microlab-unibg/GAPS_winter_monitor/Winter_PCB/Winter_v2.brd

## EAGLE design Winter_PCB/Winter_v2.brd (2022-06-06)

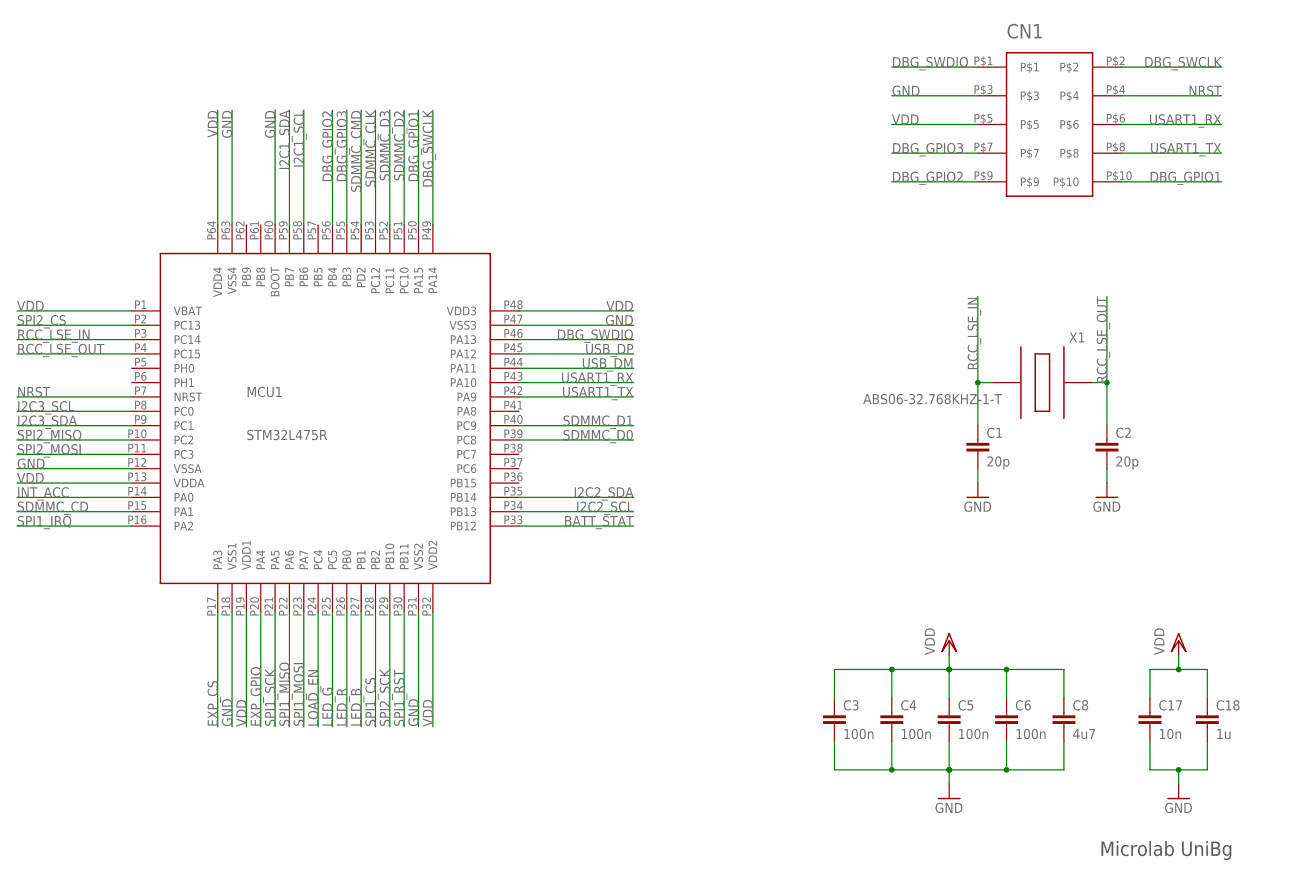
[picture p1: schematic Winter_v2.sch, sheet 1]

Parts:
C1, C2: 20p; C0402
C3, C4, C5, C6: 100n; C0402
C8: 4u7; C0402
C17: 10n; C0402
C18: 1u; C0402
CN1: FTSH-105TO; FTSH-105-XX
MCU1: STM32L475R; LQFP64
X1: ABS06-32.768KHZ-1-T; ABS06

Connections:
BATT_STAT: MCU1.P33 (PB12); also elsewhere on the board
DBG_GPIO1: CN1.P$10, MCU1.P50 (PA15)
DBG_GPIO2: CN1.P$9, MCU1.P56 (PB4)
DBG_GPIO3: CN1.P$7, MCU1.P55 (PB3)
DBG_SWCLK: CN1.P$2, MCU1.P49 (PA14)
DBG_SWDIO: CN1.P$1, MCU1.P46 (PA13)
EXP_CS: MCU1.P17 (PA3); also elsewhere on the board
EXP_GPIO: MCU1.P20 (PA4); also elsewhere on the board
GND: C1.P$2 (2), C2.P$2 (2), C3.P$2 (2), C4.P$2 (2), C5.P$2 (2), C6.P$2 (2), C8.P$2 (2), C17.P$2 (2), C18.P$2 (2), CN1.P$3, MCU1.P12 (VSSA), MCU1.P18 (VSS1), MCU1.P31 (VSS2), MCU1.P47 (VSS3), MCU1.P60 (BOOT), MCU1.P63 (VSS4); also elsewhere on the board
I2C1_SCL: MCU1.P58 (PB6); also elsewhere on the board
I2C1_SDA: MCU1.P59 (PB7); also elsewhere on the board
I2C2_SCL: MCU1.P34 (PB13); also elsewhere on the board
I2C2_SDA: MCU1.P35 (PB14); also elsewhere on the board
I2C3_SCL: MCU1.P8 (PC0); also elsewhere on the board
I2C3_SDA: MCU1.P9 (PC1); also elsewhere on the board
INT_ACC: MCU1.P14 (PA0); also elsewhere on the board
LED_B: MCU1.P27 (PB1); also elsewhere on the board
LED_G: MCU1.P25 (PC5); also elsewhere on the board
LED_R: MCU1.P26 (PB0); also elsewhere on the board
LOAD_EN: MCU1.P24 (PC4); also elsewhere on the board
NRST: CN1.P$4, MCU1.P7 (NRST)
RCC_LSE_IN: C1.P$1 (1), MCU1.P3 (PC14), X1.P1
RCC_LSE_OUT: C2.P$1 (1), MCU1.P4 (PC15), X1.P2
SDMMC_CD: MCU1.P15 (PA1); also elsewhere on the board
SDMMC_CLK: MCU1.P53 (PC12); also elsewhere on the board
SDMMC_CMD: MCU1.P54 (PD2); also elsewhere on the board
SDMMC_D0: MCU1.P39 (PC8); also elsewhere on the board
SDMMC_D1: MCU1.P40 (PC9); also elsewhere on the board
SDMMC_D2: MCU1.P51 (PC10); also elsewhere on the board
SDMMC_D3: MCU1.P52 (PC11); also elsewhere on the board
SPI1_CS: MCU1.P28 (PB2); also elsewhere on the board
SPI1_IRQ: MCU1.P16 (PA2); also elsewhere on the board
SPI1_MISO: MCU1.P22 (PA6); also elsewhere on the board
SPI1_MOSI: MCU1.P23 (PA7); also elsewhere on the board
SPI1_RST: MCU1.P30 (PB11); also elsewhere on the board
SPI1_SCK: MCU1.P21 (PA5); also elsewhere on the board
SPI2_CS: MCU1.P2 (PC13); also elsewhere on the board
SPI2_MISO: MCU1.P10 (PC2); also elsewhere on the board
SPI2_MOSI: MCU1.P11 (PC3); also elsewhere on the board
SPI2_SCK: MCU1.P29 (PB10); also elsewhere on the board
USART1_RX: CN1.P$6, MCU1.P43 (PA10)
USART1_TX: CN1.P$8, MCU1.P42 (PA9)
USB_DM: MCU1.P44 (PA11); also elsewhere on the board
USB_DP: MCU1.P45 (PA12); also elsewhere on the board
VDD: C3.P$1 (1), C4.P$1 (1), C5.P$1 (1), C6.P$1 (1), C8.P$1 (1), C17.P$1 (1), C18.P$1 (1), CN1.P$5, MCU1.P1 (VBAT), MCU1.P13 (VDDA), MCU1.P19 (VDD1), MCU1.P32 (VDD2), MCU1.P48 (VDD3), MCU1.P64 (VDD4); also elsewhere on the board

Notes on the sheet:
Microlab UniBg

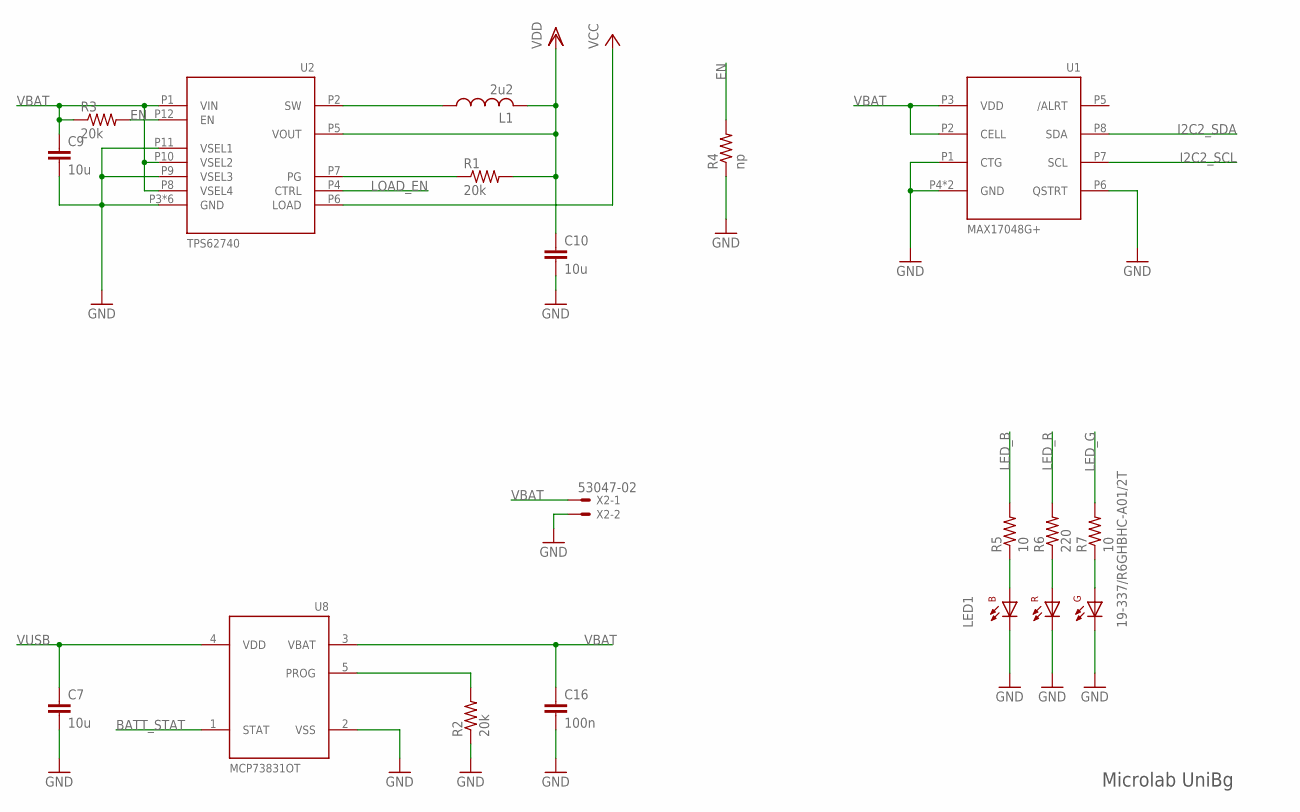
[picture p2: schematic Winter_v2.sch, sheet 2]

Parts:
C7, C9, C10: 10u; C0603
C16: 100n; C0402
L1: 2u2; C01005
LED1: 19-337/R6GHBHC-A01/2T
R1, R2, R3: 20k; 0402
R4: np; 0402
R5, R7: 10; 0402
R6: 220; 0402
U1: MAX17048G+; TDFN8-2X2
U2: TPS62740; R-PWSON-N12
U8: MCP73831OT; SOT23-5L
X2: 53047-02

Connections:
BATT_STAT: U8.1 (STAT); also elsewhere on the board
EN: R3.P$2 (2), R4.P$2 (2), U2.P12 (EN)
GND: C7.P$2 (2), C9.P$2 (2), C10.P$2 (2), C16.P$2 (2), LED1.P$1 (CB), LED1.P$2 (CR), LED1.P$3 (CG), R2.P$1 (1), R4.P$1 (1), U1.P1 (CTG), U1.P4 (GND), U1.P6 (QSTRT), U1.P9 (GND), U2.P3 (GND), U2.P9 (VSEL3), U2.P11 (VSEL1), U2.PG1 (GND), U2.PG2 (GND), U2.PG3 (GND), U2.PG4 (GND), U2.PG5 (GND), U8.2 (VSS), X2.2; also elsewhere on the board
I2C2_SCL: U1.P7 (SCL); also elsewhere on the board
I2C2_SDA: U1.P8 (SDA); also elsewhere on the board
LED_B: R5.P$2 (2); also elsewhere on the board
LED_G: R7.P$2 (2); also elsewhere on the board
LED_R: R6.P$2 (2); also elsewhere on the board
LOAD_EN: U2.P4 (CTRL); also elsewhere on the board
unnamed: L1.P$1 (1), U2.P2 (SW)
unnamed: R1.P$1 (1), U2.P7 (PG)
unnamed: LED1.P$4 (AB), R5.P$1 (1)
unnamed: LED1.P$5 (AR), R6.P$1 (1)
unnamed: LED1.P$6 (AG), R7.P$1 (1)
unnamed: R2.P$2 (2), U8.5 (PROG)
VBAT: C9.P$1 (1), C16.P$1 (1), R3.P$1 (1), U1.P2 (CELL), U1.P3 (VDD), U2.P1 (VIN), U2.P8 (VSEL4), U2.P10 (VSEL2), U8.3 (VBAT), X2.1; also elsewhere on the board
VCC: U2.P6 (LOAD); also elsewhere on the board
VDD: C10.P$1 (1), L1.P$2 (2), R1.P$2 (2), U2.P5 (VOUT); also elsewhere on the board
VUSB: C7.P$1 (1), U8.4 (VDD); also elsewhere on the board

Notes on the sheet:
Microlab UniBg

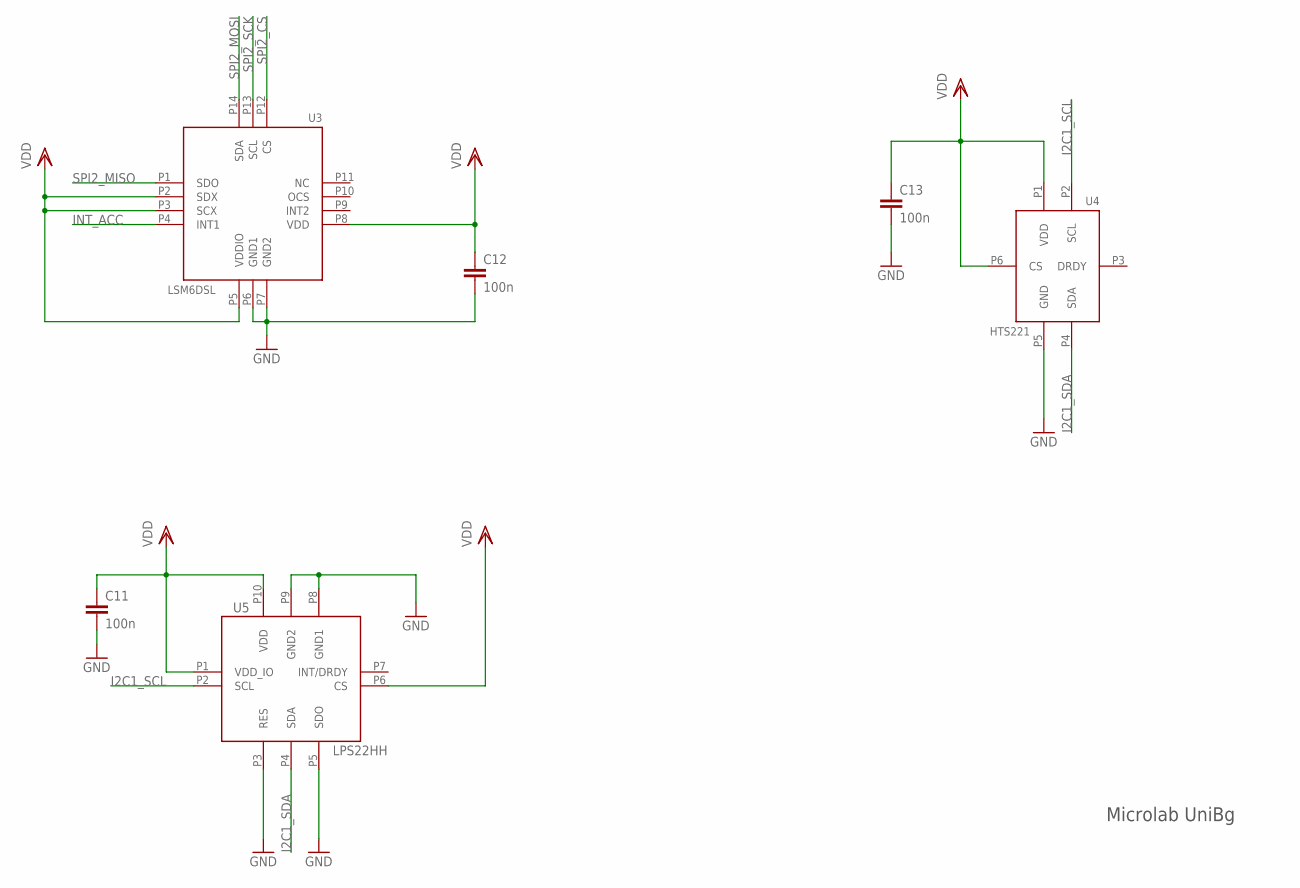
[picture p3: schematic Winter_v2.sch, sheet 3]

Parts:
C11, C12, C13: 100n; C0402
U3: LSM6DSL; LGA-14L
U4: HTS221; HCLGA-6L
U5: LPS22HH; HLGA-10L

Connections:
GND: C11.P$2 (2), C12.P$2 (2), C13.P$2 (2), U3.P6 (GND1), U3.P7 (GND2), U4.P5 (GND), U5.P3 (RES), U5.P5 (SDO), U5.P8 (GND1), U5.P9 (GND2); also elsewhere on the board
I2C1_SCL: U4.P2 (SCL), U5.P2 (SCL); also elsewhere on the board
I2C1_SDA: U4.P4 (SDA), U5.P4 (SDA); also elsewhere on the board
INT_ACC: U3.P4 (INT1); also elsewhere on the board
SPI2_CS: U3.P12 (CS); also elsewhere on the board
SPI2_MISO: U3.P1 (SDO); also elsewhere on the board
SPI2_MOSI: U3.P14 (SDA); also elsewhere on the board
SPI2_SCK: U3.P13 (SCL); also elsewhere on the board
VDD: C11.P$1 (1), C12.P$1 (1), C13.P$1 (1), U3.P2 (SDX), U3.P3 (SCX), U3.P5 (VDDIO), U3.P8 (VDD), U4.P1 (VDD), U4.P6 (CS), U5.P1 (VDD_IO), U5.P6 (CS), U5.P10 (VDD); also elsewhere on the board

Notes on the sheet:
Microlab UniBg

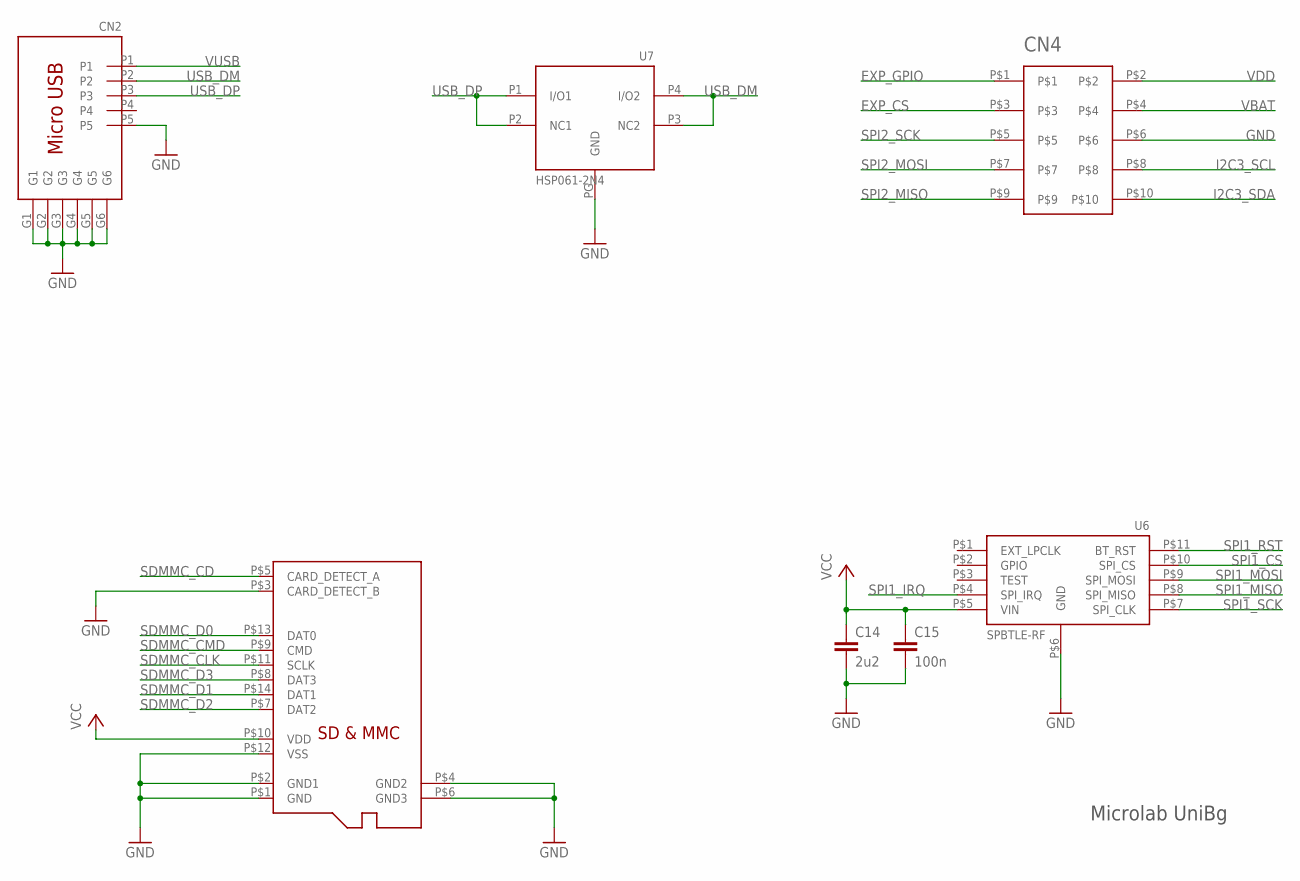
[picture p4: schematic Winter_v2.sch, sheet 4]

Parts:
C14: 2u2; C0402
C15: 100n; C0402
CN2: USB3075
CN3: MICRO_SD-5025700893; 5025700893
CN4: FTSH-105TO; FTSH-105-XX
U6: SPBTLE-RF
U7: HSP061-2N4; μQFN-4L

Connections:
EXP_CS: CN4.P$3; also elsewhere on the board
EXP_GPIO: CN4.P$1; also elsewhere on the board
GND: C14.P$2 (2), C15.P$2 (2), CN2.G1, CN2.G2, CN2.G3, CN2.G4, CN2.G5, CN2.G6, CN2.P5, CN3.P$1 (GND), CN3.P$2 (GND1), CN3.P$3 (CARD_DETECT_B), CN3.P$4 (GND2), CN3.P$6 (GND3), CN3.P$12 (VSS), CN4.P$6, U6.P$6 (GND), U7.PG (GND); also elsewhere on the board
I2C3_SCL: CN4.P$8; also elsewhere on the board
I2C3_SDA: CN4.P$10; also elsewhere on the board
SDMMC_CD: CN3.P$5 (CARD_DETECT_A); also elsewhere on the board
SDMMC_CLK: CN3.P$11 (SCLK); also elsewhere on the board
SDMMC_CMD: CN3.P$9 (CMD); also elsewhere on the board
SDMMC_D0: CN3.P$13 (DAT0); also elsewhere on the board
SDMMC_D1: CN3.P$14 (DAT1); also elsewhere on the board
SDMMC_D2: CN3.P$7 (DAT2); also elsewhere on the board
SDMMC_D3: CN3.P$8 (DAT3); also elsewhere on the board
SPI1_CS: U6.P$10 (SPI_CS); also elsewhere on the board
SPI1_IRQ: U6.P$4 (SPI_IRQ); also elsewhere on the board
SPI1_MISO: U6.P$8 (SPI_MISO); also elsewhere on the board
SPI1_MOSI: U6.P$9 (SPI_MOSI); also elsewhere on the board
SPI1_RST: U6.P$11 (BT_RST); also elsewhere on the board
SPI1_SCK: U6.P$7 (SPI_CLK); also elsewhere on the board
SPI2_MISO: CN4.P$9; also elsewhere on the board
SPI2_MOSI: CN4.P$7; also elsewhere on the board
SPI2_SCK: CN4.P$5; also elsewhere on the board
USB_DM: CN2.P2, U7.P3 (NC2), U7.P4 (I/O2); also elsewhere on the board
USB_DP: CN2.P3, U7.P1 (I/O1), U7.P2 (NC1); also elsewhere on the board
VBAT: CN4.P$4; also elsewhere on the board
VCC: C14.P$1 (1), C15.P$1 (1), CN3.P$10 (VDD), U6.P$5 (VIN); also elsewhere on the board
VDD: CN4.P$2; also elsewhere on the board
VUSB: CN2.P1; also elsewhere on the board

Notes on the sheet:
Microlab UniBg

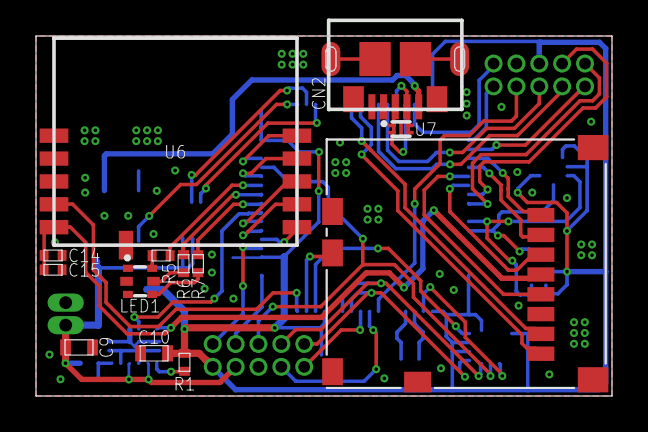
[picture p5: board Winter_v2.brd from above]

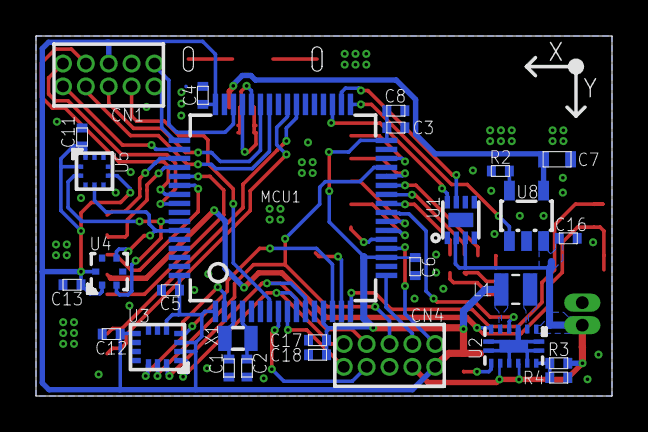
[picture p6: board Winter_v2.brd from below]

Board: 2 copper layers, 32.0 x 20.0 mm, 43 parts (28 on the bottom side), 55 nets.

Other parts of the board:
DRILEGEND: DRILEGEND
