microlab-unibg/GAPS_winter_monitor/Winter_v2/Src/main.c

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

/* Includes ------------------------------------------------------------------*/
#include "main.h"

/* USER CODE BEGIN Includes */
#include "app.h"
/* USER CODE END Includes */

I2C_HandleTypeDef hi2c1;
I2C_HandleTypeDef hi2c2;
I2C_HandleTypeDef hi2c3;

RTC_HandleTypeDef hrtc;

SPI_HandleTypeDef hspi1;
SPI_HandleTypeDef hspi2;

void SystemClock_Config(void);
static void MX_GPIO_Init(void);
static void MX_I2C1_Init(void);
static void MX_I2C2_Init(void);
static void MX_I2C3_Init(void);
static void MX_SPI1_Init(void);
static void MX_SPI2_Init(void);
static void MX_RTC_Init(void);
/* USER CODE BEGIN 0 */
extern volatile Winter_t winter;
/* USER CODE END 0 */

/**
  * @brief  The application entry point.
  * @retval int
  */
int main(void)
{
  /* MCU Configuration--------------------------------------------------------*/

  /* Reset of all peripherals, Initializes the Flash interface and the Systick. */
  HAL_Init();

  /* Configure the system clock */
  SystemClock_Config();

  /* Initialize all configured peripherals */
  MX_GPIO_Init();
  MX_I2C1_Init();
  MX_I2C2_Init();
  MX_I2C3_Init();
  MX_SPI1_Init();
  MX_SPI2_Init();
  MX_RTC_Init();
  /* USER CODE BEGIN 2 */
	App_InitSystem();
  /* USER CODE END 2 */

  /* Infinite loop */
  /* USER CODE BEGIN WHILE */
	while (1) {
    /* USER CODE END WHILE */

    /* USER CODE BEGIN 3 */
		if (App_GetSystemState() == SYSTEM_STATE_SLEEP) {
			Enter_Stop2_Mode();
			Exit_Stop2_Mode();
		}
	}
  /* USER CODE END 3 */
}

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
/* USER CODE BEGIN 4 */
/**
 * @brief  Write an amount of data in the specified device and register, in
 * 		   blocking mode.
 * @param  i2c        I2C_e enumeration value.
 * @param  DevAddress Target device address.
 * @param  pData 	  Pointer to data buffer.
 * @param  Size 	  Amount of data to be sent.
 * @return HAL status.
 */
uint8_t I2C_Write(I2C_e i2c, uint8_t DevAddress, uint8_t* pData, uint8_t Size) {
	HAL_StatusTypeDef res = HAL_OK;

	switch (i2c) {
		case I2C_ENV:
			res |= HAL_I2C_Master_Transmit(&hi2c1, DevAddress, pData, Size,
					100);
			break;
		case I2C_GAS:
			res |= HAL_I2C_Master_Transmit(&hi2c2, DevAddress, pData, Size,
					100);
			break;
		case I2C_EXP:
			res |= HAL_I2C_Master_Transmit(&hi2c3, DevAddress, pData, Size,
					100);
			break;
		default:
			break;
	}

	return res;
}

/**
 * @brief  Read an amount of data from the specified device and register, in
 * 		   blocking mode.
 * @param  i2c        I2C_e enumeration value.
 * @param  DevAddress Target device address.
 * @param  RegAddress Target register address.
 * @param  pData 	  Pointer to data buffer.
 * @param  Size 	  Amount of data to be sent.
 * @return HAL status.
 */
uint8_t I2C_Read(I2C_e i2c, uint8_t DevAddress, uint8_t RegAddress,
		uint8_t* pData, uint16_t Size) {
	HAL_StatusTypeDef res = HAL_OK;

	switch (i2c) {
		case I2C_ENV:
			res |= HAL_I2C_Master_Transmit(&hi2c1, DevAddress, &RegAddress, 1,
					100);
			if (res == HAL_OK)
				res |= HAL_I2C_Master_Receive(&hi2c1, DevAddress, pData, Size,
						100);
			break;
		case I2C_GAS:
			res |= HAL_I2C_Master_Transmit(&hi2c2, DevAddress, &RegAddress, 1,
					100);
			if (res == HAL_OK)
				res |= HAL_I2C_Master_Receive(&hi2c2, DevAddress, pData, Size,
						100);
			break;
		case I2C_EXP:
			res |= HAL_I2C_Master_Transmit(&hi2c3, DevAddress, &RegAddress, 1,
					100);
			if (res == HAL_OK)
				res |= HAL_I2C_Master_Receive(&hi2c3, DevAddress, pData, Size,
						100);
			break;
		default:
			res = HAL_ERROR;
			break;
	}

	return res;
}

/**
 * @brief  Write an amount of data in the specified device, in blocking mode.
 * @param  spi   SPI_e enumeration value.
 * @param  pData Pointer to data buffer.
 * @param  Size  Amount of data to be sent.
 * @return HAL status.
 */
uint8_t SPI_Write(SPI_e spi, uint8_t* pData, uint16_t Size) {
	HAL_StatusTypeDef res = HAL_OK;

	switch (spi) {
		case SPI_BLE:
			break;
		case SPI_MOTION:
			HAL_GPIO_WritePin(MOT_CS_GPIO_Port, MOT_CS_Pin, GPIO_PIN_RESET);
			res |= HAL_SPI_Transmit(&hspi2, pData, Size, 100);
			HAL_GPIO_WritePin(MOT_CS_GPIO_Port, MOT_CS_Pin, GPIO_PIN_SET);
			break;
		case SPI_EXP:
			HAL_GPIO_WritePin(EXP_CS_GPIO_Port, EXP_CS_Pin, GPIO_PIN_RESET);
			res |= HAL_SPI_Transmit(&hspi2, pData, Size, 100);
			HAL_GPIO_WritePin(EXP_CS_GPIO_Port, EXP_CS_Pin, GPIO_PIN_SET);
		default:
			res = HAL_ERROR;
			break;
	}

	return res;
}

/**
 * @brief  Read an amount of data in the specified device, in blocking mode.
 * @param  spi        SPI_e enumeration value.
 * @param  RegAddress Target register address.
 * @param  pData      Pointer to data buffer.
 * @param  Size       Amount of data to be sent.
 * @return HAL status.
 */
uint8_t SPI_Read(SPI_e spi, uint8_t RegAddress, uint8_t* pData, uint16_t Size) {
	HAL_StatusTypeDef res = HAL_OK;

	switch (spi) {
		case SPI_BLE:
			break;
		case SPI_MOTION:
			HAL_GPIO_WritePin(MOT_CS_GPIO_Port, MOT_CS_Pin, GPIO_PIN_RESET);
			pData[0] = 0;
			res |= HAL_SPI_Transmit(&hspi2, &RegAddress, 1, 100);
			res |= HAL_SPI_Receive(&hspi2, pData, Size, 100);
			HAL_GPIO_WritePin(MOT_CS_GPIO_Port, MOT_CS_Pin, GPIO_PIN_SET);
			break;
		case SPI_EXP:
			HAL_GPIO_WritePin(EXP_CS_GPIO_Port, EXP_CS_Pin, GPIO_PIN_RESET);
			res |= HAL_SPI_Transmit(&hspi2, &RegAddress, 1, 100);
			res |= HAL_SPI_Receive(&hspi2, pData, Size, 100);
			HAL_GPIO_WritePin(EXP_CS_GPIO_Port, EXP_CS_Pin, GPIO_PIN_SET);
			break;
		default:
			res = HAL_ERROR;
			break;
	}

	return res;
}

void Enable_LPR_Mode(void) {

	/* *** Low-power run mode ***
	 * ==========================
	 *    [..]
	 *       (+) Entry: (from main run mode)
	 *          (++) set LPR bit with HAL_PWREx_EnableLowPowerRunMode() API
	 *               after having decreased the system clock below 2 MHz.
	 */

	RCC_OscInitTypeDef RCC_OscInitStruct = { 0 };
//	RCC_ClkInitTypeDef RCC_ClkInitStruct = { 0 };

//	/** Adjust divider for SD card interface and re-initialize it
//	 */
//	FRESULT result;
//	result = f_mount(0, SDPath, 1);				// un-mount
//	hsd1.Init.ClockDiv = 0;
//	result |= f_mount(&FatFsDisk, SDPath, 1);	// mount again
//	if (result != FR_OK) {
//		Error_Handler();
//	}

	/** Initializes the CPU, AHB and APB busses clocks
	 */
	RCC_OscInitStruct.OscillatorType = RCC_OSCILLATORTYPE_MSI;
	RCC_OscInitStruct.MSIState = RCC_MSI_ON;
	RCC_OscInitStruct.MSICalibrationValue = 0;
	RCC_OscInitStruct.MSIClockRange = RCC_MSIRANGE_4;
	RCC_OscInitStruct.PLL.PLLState = RCC_PLL_NONE;
	if (HAL_RCC_OscConfig(&RCC_OscInitStruct) != HAL_OK) {
		Error_Handler();
	}

//	/** Initializes the CPU, AHB and APB busses clocks
//	 */
//	RCC_ClkInitStruct.ClockType = RCC_CLOCKTYPE_HCLK; // | RCC_CLOCKTYPE_SYSCLK;
//	RCC_ClkInitStruct.SYSCLKSource = RCC_SYSCLKSOURCE_MSI;
//	RCC_ClkInitStruct.AHBCLKDivider = RCC_SYSCLK_DIV8;
//	if (HAL_RCC_ClockConfig(&RCC_ClkInitStruct, FLASH_LATENCY_0) != HAL_OK) {
//		Error_Handler();
//	}

//	/** Disable HSI to reduce power consumption
//	 */
//	__HAL_RCC_HSI_DISABLE();

	/** Enter the Low Power Run Mode
	 */
	HAL_PWREx_EnableLowPowerRunMode();

	// Set the LP Mode flag
	winter.lprEnabled = 1;
}

void Disable_LPR_Mode(void) {

	/* *** Low-power run mode ***
	 * ==========================
	 * 	  [..]
	 * 	     (+) Exit:
	 * 	        (++) clear LPR bit then wait for REGLP bit to be reset with
	 * 	        	 HAL_PWREx_DisableLowPowerRunMode() API. Only then can the
	 * 	        	 system clock frequency be increased above 2 MHz.
	 */

	RCC_OscInitTypeDef RCC_OscInitStruct = { 0 };
//	RCC_ClkInitTypeDef RCC_ClkInitStruct = { 0 };

	/** Exit the Low Power Run Mode
	 */
	HAL_PWREx_DisableLowPowerRunMode();

//	/** Enable HSI
//	 */
//	__HAL_RCC_HSI_ENABLE();

	/** Initializes the CPU, AHB and APB busses clocks
	 */
	RCC_OscInitStruct.OscillatorType = RCC_OSCILLATORTYPE_MSI;
	RCC_OscInitStruct.MSIState = RCC_MSI_ON;
	RCC_OscInitStruct.MSICalibrationValue = 0;
	RCC_OscInitStruct.MSIClockRange = RCC_MSIRANGE_7;
	RCC_OscInitStruct.PLL.PLLState = RCC_PLL_NONE;
	if (HAL_RCC_OscConfig(&RCC_OscInitStruct) != HAL_OK) {
		Error_Handler();
	}

//	/** Initializes the CPU, AHB and APB busses clocks
//	 */
//	RCC_ClkInitStruct.ClockType = RCC_CLOCKTYPE_SYSCLK | RCC_CLOCKTYPE_HCLK;
//	RCC_ClkInitStruct.SYSCLKSource = RCC_SYSCLKSOURCE_HSI;
//	RCC_ClkInitStruct.AHBCLKDivider = RCC_SYSCLK_DIV1;
//	if (HAL_RCC_ClockConfig(&RCC_ClkInitStruct, FLASH_LATENCY_0) != HAL_OK) {
//		Error_Handler();
//	}

//	/** Re-initialize the SD card interface
//	 */
//	FRESULT result;
//	result = f_mount(0, SDPath, 1);				// un-mount
//	result |= f_mount(&FatFsDisk, SDPath, 1);	// mount again
//	if (result != FR_OK) {
//		Error_Handler();
//	}

// Reset the LP Mode flag
	winter.lprEnabled = 0;
}

void GPIO_Deinit(void) {
	GPIO_InitTypeDef GPIO_InitStruct = { 0 };

	/* EXTI interrupt deinit*/
	HAL_NVIC_DisableIRQ(EXTI2_IRQn);

	/*Configure GPIO pins : PA1 PA2 PA3 PA4 PA15 */
	GPIO_InitStruct.Pin = SD_CD_Pin | BLE_IRQ_Pin | EXP_CS_Pin | EXP_GPIO_Pin
			| DBG_GPIO1_Pin;
	GPIO_InitStruct.Mode = GPIO_MODE_ANALOG;
	GPIO_InitStruct.Pull = GPIO_NOPULL;
	HAL_GPIO_Init(GPIOA, &GPIO_InitStruct);

	/*Configure GPIO pins : PB0 PB1 PB2 PB3 PB4 PB11 PB12 */
	GPIO_InitStruct.Pin = LED_RED_Pin | LED_BLUE_Pin | BLE_CS_Pin
			| DBG_GPIO3_Pin | DBG_GPIO2_Pin | BLE_RST_Pin | BATT_STAT_Pin;
	GPIO_InitStruct.Mode = GPIO_MODE_ANALOG;
	GPIO_InitStruct.Pull = GPIO_NOPULL;
	HAL_GPIO_Init(GPIOB, &GPIO_InitStruct);

	/*Configure GPIO pins : PC4 PC5 PC8 PC9 PC10 PC11 PC12 PC13 */
	GPIO_InitStruct.Pin = LOAD_EN_Pin | LED_GREEN_Pin | MOT_CS_Pin;
	GPIO_InitStruct.Mode = GPIO_MODE_ANALOG;
	GPIO_InitStruct.Pull = GPIO_NOPULL;
	HAL_GPIO_Init(GPIOC, &GPIO_InitStruct);

	/*Configure GPIO pins : PD2 */
	//GPIO_InitStruct.Pin = SD_CMD_Pin;
	GPIO_InitStruct.Mode = GPIO_MODE_ANALOG;
	GPIO_InitStruct.Pull = GPIO_NOPULL;
	HAL_GPIO_Init(GPIOD, &GPIO_InitStruct);

	// Set SDA and SCL pins of I2C1 e I2C2 to PUSH PULL with HIGH level
	// (alternatively, OPEN DRAIN with PULL-UP)
	/*Configure GPIO pins : PD2 */
	HAL_GPIO_WritePin(GPIOB,
			ENV_SCL_Pin | ENV_SDA_Pin | GAS_SCL_Pin | GAS_SDA_Pin,
			GPIO_PIN_SET);
	GPIO_InitStruct.Pin = ENV_SCL_Pin | ENV_SDA_Pin | GAS_SCL_Pin | GAS_SDA_Pin;
	GPIO_InitStruct.Mode = GPIO_MODE_OUTPUT_PP;
	GPIO_InitStruct.Pull = GPIO_NOPULL;
	HAL_GPIO_Init(GPIOB, &GPIO_InitStruct);

	/* GPIO Ports Clock Enable */
	__HAL_RCC_GPIOA_CLK_DISABLE();
	__HAL_RCC_GPIOB_CLK_DISABLE();
	__HAL_RCC_GPIOC_CLK_DISABLE();
	__HAL_RCC_GPIOD_CLK_DISABLE();
	__HAL_RCC_GPIOH_CLK_DISABLE();
}

void Enter_Stop2_Mode(void) {
	/*
	 * *** Stop 2 mode ***
	 * ==========================
	 * Stop 2 mode can only be entered from Run mode. It is not
	 * possible to enter Stop 2 mode from the Low-power run mode.
	 */

	// Check the current LPR state
	if (winter.lprEnabled) Disable_LPR_Mode();

	// Deinitialize external peripherals and user-defined IRQs
	App_DeinitPeripherals();
	HAL_NVIC_DisableIRQ(BLE_JOB_IRQn);
	HAL_NVIC_DisableIRQ(JOB_IRQn);

	// Deinitialize internal peripherals
	HAL_I2C_DeInit(&hi2c1);
	HAL_I2C_DeInit(&hi2c2);
	HAL_I2C_DeInit(&hi2c3);
	HAL_SPI_DeInit(&hspi1);

	// Deinitialize the SD card and the related GPIOs
	//FATFS_UnLinkDriver(SDPath);		// equivalent to a MX_FATFS_Deinit() call
	//HAL_SD_DeInit(&hsd1);

	// Disable VCC
	IO_Enable_VCC(GPIO_PIN_RESET);

	// Set to analog all the GPIOs
	GPIO_Deinit();

	// Configure the clock source used after wake up from stop
	__HAL_RCC_WAKEUPSTOP_CLK_CONFIG(RCC_STOP_WAKEUPCLOCK_MSI);

	// Finally, suspend the SysTick to prevent its interrupts
	HAL_SuspendTick();

	// Define Wake-up with RTC

	// With clock DIV16 -> frequency wake up clock is 32768/16 = 2048 Hz
	// Note: DO NOT EXCEED FFFF value!!!
	// HAL_RTCEx_SetWakeUpTimer_IT(&hrtc, 0xFFFF, RTC_WAKEUPCLOCK_RTCCLK_DIV16);

	// With ck_spre -> frequency wake up clock is 1 Hz
	// Note: DO NOT EXCEED FFFF value!!!
	HAL_RTCEx_SetWakeUpTimer_IT(&hrtc, WAKEUP_COUNTER, RTC_WAKEUPCLOCK_CK_SPRE_16BITS);

	// Enter Stop 2 Mode
	HAL_PWREx_EnterSTOP2Mode(PWR_STOPENTRY_WFI);
}

void Exit_Stop2_Mode(void) {
	// First, re-configure the system clock
	SystemClock_Config();

	// Resume the SysTick
	HAL_ResumeTick();

	// Re-initialize internal peripherals
	MX_GPIO_Init();
	MX_I2C1_Init();
	MX_I2C2_Init();
	MX_I2C3_Init();
	//MX_SDMMC1_SD_Init();
	MX_SPI1_Init();
	MX_SPI2_Init();
	//MX_FATFS_Init();

	//TODO Check the SD card since it wasn't working at this point
	//f_mount(&FatFsDisk, SDPath, 1);

	// Finally, re-initialize the system
	//TODO Maybe ->IDLE? Then, explicitly resume the LPR mode and BLE_Init()
	App_InitSystem();
}

/* USER CODE END 4 */
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
