microlab-unibg/GAPS_winter_monitor/Winter_v2/Winter_v2.ioc

Mcu.UserName=STM32L475RGTx
PA0.GPIO_Label=INT_ACC
PA0.Signal=GPXTI0
PA1.GPIO_Label=SD_CD
PA1.Signal=GPIO_Input
PA2.GPIO_Label=BLE_IRQ
PA2.Signal=GPXTI2
PA3.GPIO_Label=EXP_CS
PA3.Signal=GPIO_Output
PA4.GPIO_Label=EXP_GPIO
PA4.Signal=GPIO_Input
PA5.GPIO_Label=BLE_SCK
PA5.Signal=SPI1_SCK
PA6.GPIO_Label=BLE_MISO
PA6.Signal=SPI1_MISO
PA7.GPIO_Label=BLE_MOSI
PA7.Signal=SPI1_MOSI
PB0.GPIO_Label=LED_RED
PB0.Signal=GPIO_Output
PB1.GPIO_Label=LED_BLUE
PB1.Signal=GPIO_Output
PB10.GPIO_Label=MISC_SCK
PB10.Signal=SPI2_SCK
PB11.GPIO_Label=BLE_RST
PB11.Signal=GPIO_Output
PB12.GPIO_Label=BATT_STAT
PB12.Signal=GPIO_Input
PB13.GPIO_Label=GAS_SCL
PB13.Signal=I2C2_SCL
PB14.GPIO_Label=GAS_SDA
PB14.Signal=I2C2_SDA
PB2.GPIO_Label=BLE_CS
PB2.Signal=GPIO_Analog
PB6.GPIO_Label=ENV_SCL
PB6.Signal=I2C1_SCL
PB7.GPIO_Label=ENV_SDA
PB7.Signal=I2C1_SDA
PC0.GPIO_Label=EXP_SCL
PC0.Signal=I2C3_SCL
PC1.GPIO_Label=EXP_SDA
PC1.Signal=I2C3_SDA
PC13.GPIO_Label=MOT_CS
PC13.Signal=GPIO_Output
PC2.GPIO_Label=MISC_MISO
PC2.Signal=SPI2_MISO
PC3.GPIO_Label=MISC_MOSI
PC3.Signal=SPI2_MOSI
PC4.GPIO_Label=LOAD_EN
PC4.Signal=GPIO_Output
PC5.GPIO_Label=LED_GREEN
PC5.Signal=GPIO_Output
