microlab-unibg/GAPS_winter_monitor/Winter_v2/Inc/main.h

#define MOT_CS_Pin GPIO_PIN_13
#define MOT_CS_GPIO_Port GPIOC
#define EXP_SCL_Pin GPIO_PIN_0
#define EXP_SCL_GPIO_Port GPIOC
#define EXP_SDA_Pin GPIO_PIN_1
#define EXP_SDA_GPIO_Port GPIOC
#define MISC_MISO_Pin GPIO_PIN_2
#define MISC_MISO_GPIO_Port GPIOC
#define MISC_MOSI_Pin GPIO_PIN_3
#define MISC_MOSI_GPIO_Port GPIOC
#define INT_ACC_Pin GPIO_PIN_0
#define INT_ACC_GPIO_Port GPIOA
#define INT_ACC_EXTI_IRQn EXTI0_IRQn
#define SD_CD_Pin GPIO_PIN_1
#define SD_CD_GPIO_Port GPIOA
#define BLE_IRQ_Pin GPIO_PIN_2
#define BLE_IRQ_GPIO_Port GPIOA
#define BLE_IRQ_EXTI_IRQn EXTI2_IRQn
#define EXP_CS_Pin GPIO_PIN_3
#define EXP_CS_GPIO_Port GPIOA
#define EXP_GPIO_Pin GPIO_PIN_4
#define EXP_GPIO_GPIO_Port GPIOA
#define BLE_SCK_Pin GPIO_PIN_5
#define BLE_SCK_GPIO_Port GPIOA
#define BLE_MISO_Pin GPIO_PIN_6
#define BLE_MISO_GPIO_Port GPIOA
#define BLE_MOSI_Pin GPIO_PIN_7
#define BLE_MOSI_GPIO_Port GPIOA
#define LOAD_EN_Pin GPIO_PIN_4
#define LOAD_EN_GPIO_Port GPIOC
#define LED_GREEN_Pin GPIO_PIN_5
#define LED_GREEN_GPIO_Port GPIOC
#define LED_RED_Pin GPIO_PIN_0
#define LED_RED_GPIO_Port GPIOB
#define LED_BLUE_Pin GPIO_PIN_1
#define LED_BLUE_GPIO_Port GPIOB
#define BLE_CS_Pin GPIO_PIN_2
#define BLE_CS_GPIO_Port GPIOB
#define MISC_SCK_Pin GPIO_PIN_10
#define MISC_SCK_GPIO_Port GPIOB
#define BLE_RST_Pin GPIO_PIN_11
#define BLE_RST_GPIO_Port GPIOB
#define BATT_STAT_Pin GPIO_PIN_12
#define BATT_STAT_GPIO_Port GPIOB
#define GAS_SCL_Pin GPIO_PIN_13
#define GAS_SCL_GPIO_Port GPIOB
#define GAS_SDA_Pin GPIO_PIN_14
#define GAS_SDA_GPIO_Port GPIOB
#define DBG_GPIO1_Pin GPIO_PIN_15
#define DBG_GPIO1_GPIO_Port GPIOA
#define DBG_GPIO3_Pin GPIO_PIN_3
#define DBG_GPIO3_GPIO_Port GPIOB
#define DBG_GPIO2_Pin GPIO_PIN_4
#define DBG_GPIO2_GPIO_Port GPIOB
#define ENV_SCL_Pin GPIO_PIN_6
#define ENV_SCL_GPIO_Port GPIOB
#define ENV_SDA_Pin GPIO_PIN_7
#define ENV_SDA_GPIO_Port GPIOB
