microlab-unibg/GAPS_winter_monitor/Winter_v2/Src/app.c

/**
 ******************************************************************************
 * @file           : app.c
 * @brief          : Implementation of application
 * @author		   : Patrick Locatelli (patrick.locatelli@unibg.it)
 * @version		   : 1.0
 * @date    	   : 13 Feb 2020
 ******************************************************************************
 */

/* Includes ------------------------------------------------------------------*/
#include "app.h"
#include "log.h"

/* Private define ------------------------------------------------------------*/
#define LOG_NAME_SIZE	15

/* Private variables ---------------------------------------------------------*/
Winter_t winter = { .state = SYSTEM_STATE_STARTUP, .oldState =
		SYSTEM_STATE_ERROR, .period = 1000, .lprEnabled = 0, .logSensors = 0,
		.lastActivityTime = 0, .scheduledOperation = OP_NONE, .cardMounted = 0,
		.reachedLogBufferEnd = 0 };
PeripheralsInitStatus_t initStatus = { .LSM6DSL = 0, .HTS221 = 0, .LPS22HH = 0,
		.BLE = 0, .MAX17048 = 0, .batteryLevel = -1 };
LatestData_t latestData;

uint32_t myTick;
uint32_t myEpoch;

/* Extern variables ----------------------------------------------------------*/
extern DMA_HandleTypeDef hdma_memtomem_dma2_channel1;
extern char SDPath[4];

/* Private function prototypes -----------------------------------------------*/
void init_Winter(void);
uint8_t init_LSM6DSL(void);
uint8_t init_HTS221(void);
uint8_t init_LPS22HH(void);
uint8_t init_BluetoothLowEnergy(void);
uint8_t deinit_HTS221(void);
uint8_t deinit_LPS22HH(void);
void deinit_BluetoothLowEnergy(void);
uint8_t do_InitJob(void);
void do_IdleJob(void);
void do_LogJob(void);
void do_ErrorJob(void);
void handle_ScheduledOperations(void);
uint8_t updateData(void);
void set_LogSensors(uint8_t sensors);
void set_LogFrequency(uint16_t frequency);

/*
 * @brief  Get the current main job period.
 * @param  None.
 * @return The current main job period.
 */
uint16_t App_GetPeriod(void) {
	return winter.period;
}

uint8_t App_MyDebug(uint8_t led) {
	RTC_GetDateTime_Epoch(&myEpoch);
if ((myEpoch % 100) == 0) {
		IO_SetLED(led);
		HAL_Delay(100);
		IO_ResetLED(led);
	}
}

/*
 * @brief Set the main job period.
 * @param p The new main job period.
 */
void App_SetPeriod(uint16_t p) {
	winter.period = p;
}

/*
 * @brief  Get the current system state.
 * @param  None.
 * @return The current system state.
 */
SystemState_e App_GetSystemState(void) {
	return winter.state;
}

/*
 * @brief  Set the system state.
 * @param  s The new system state.
 * @return The success of the operation.
 */
uint8_t App_SetSystemState(SystemState_e s) {
	if (s != App_GetSystemState()) {
		// State exiting conditions
		switch (winter.state) {
			case SYSTEM_STATE_INIT:
				IO_ResetLED(LED_BLUE);
				break;
			case SYSTEM_STATE_IDLE:
			case SYSTEM_STATE_IDLE_CONNECTED:
				if (s == SYSTEM_STATE_IDLE || s == SYSTEM_STATE_IDLE_CONNECTED)
					__NOP();
				else
					IO_ResetLED(LED_GREEN | LED_BLUE);
				break;
			case SYSTEM_STATE_LOG:
				IO_ResetLED(LED_GREEN);
				break;
			case SYSTEM_STATE_ERROR:
				IO_ResetLED(LED_RED);
				break;
			default:
				break;
		}

		// State entering conditions
		switch (s) {
			case SYSTEM_STATE_INIT:
				IO_SetLED(LED_BLUE);
				break;
			case SYSTEM_STATE_IDLE:
			case SYSTEM_STATE_IDLE_CONNECTED:
				IO_SetLED(LED_GREEN);
				if (winter.state == SYSTEM_STATE_IDLE
						|| winter.state == SYSTEM_STATE_IDLE_CONNECTED) {
					/*
					 * If the transition is IDLE <-> IDLE_CONNECTED (either in
					 * one direction or the opposite), there's nothing to do
					 */
				} else {
					// Disable the double-tap detection
					LSM6DSL_Enable_DoubleTapInterrupt(0);

					// Turn OFF the sensors
					LSM6DSL_PowerDown_Axl(1);
					LSM6DSL_PowerDown_Gyro(1);

					// Finally, enter the Low Power Run mode
					if (!winter.lprEnabled) Enable_LPR_Mode();

					// Set the new app period
					App_SetPeriod(PERIOD_IDLE);
				}
				break;
			case SYSTEM_STATE_SLEEP:
				// Activate the accelerometer
				LSM6DSL_PowerDown_Axl(0);

				// Slow down the accelerometer to reduce power consumption
				LSM6DSL_Set_Axl_ODR(LSM6DSL_ODR_104Hz);

				// Enable the double-tap detection
				//LSM6DSL_Enable_DoubleTapInterrupt(1);

				break;
			case SYSTEM_STATE_LOG:
				// Check the SD presence
				/*if (!BSP_SD_IsDetected()) return 0;

				// Try to initialize the log
				char logName[LOG_NAME_SIZE];
				RTC_GetDateTime_FormattedChar(logName);
				if (!Log_Create_DataFile(logName)) {
					return 0;
				}
				 */
				// Turn ON the inertial sensors needed required for the log
				if ((winter.logSensors & SENS_AXL) != 0)
					LSM6DSL_PowerDown_Axl(0);
				if ((winter.logSensors & SENS_GYRO) != 0)
					LSM6DSL_PowerDown_Gyro(0);

				// Set the new app period
				App_SetPeriod(1000 / winter.logFrequency);
				break;
			case SYSTEM_STATE_ERROR:
				App_SetPeriod(PERIOD_ERROR);
				break;
			default:
				break;
		}

		// Change the state
		winter.oldState = winter.state;
		winter.state = s;

		// Update the last activity time and reset the tick counter
		App_UpdateLastActivityTime();
		// myTick = 0;
	}

	return s == App_GetSystemState();
}

/*
 * @brief  Schedule a new operation.
 * @param  operation The operation to be scheduled.
 * @return None.
 */
void App_ScheduleOperation(ScheduledOp_e operation) {
	winter.scheduledOperation = operation;
}

/*
 * @brief  Update the current time as the latest activity time.
 * @param  None.
 * @return None.
 */
void App_UpdateLastActivityTime(void) {
	winter.lastActivityTime = HAL_GetTick();
}

/*
 * @brief  Start the log of the selected sensors, at the selected frequency.
 * @param  sensors The sensors to be logged. Each bit corresponds to a specific
 * 				   sensor, according to the masks defined in app.h.
 * @param  frequency The log frequency.
 * @return The success of the operation.
 */
uint8_t App_StartLog(uint8_t sensors, uint16_t frequency) {

	// Limit the log frequency to the maximum allowed
	if (frequency > MAXIMUM_LOG_FREQUENCY)
		frequency = MAXIMUM_LOG_FREQUENCY;

	// Set the log parameters
	set_LogSensors(sensors);
	set_LogFrequency(frequency);

	// Enter the log state
	if (!App_SetSystemState(SYSTEM_STATE_LOG)) {
		App_SetSystemState(SYSTEM_STATE_ERROR);
		return 0;
	} else
		return 1;
}

/*
 * @brief  Stop the current log session.
 * @param  None.
 * @return The success of the operation.
 */
uint8_t App_StopLog() {
	uint8_t result = 1;
	//result &= Log_Close_DataFile(1);
	result &= App_SetSystemState(SYSTEM_STATE_IDLE_CONNECTED);
	return result;
}

/*
 * @brief  Initialize the system.
 * @param  None.
 * @return The success of the operation.
 */
uint8_t App_InitSystem(void) {
	uint8_t result = 1;
	myTick = 0;

	// Set the state as INIT
	result &= App_SetSystemState(SYSTEM_STATE_INIT);

	// Register and enable priority of the job interrupt
	HAL_NVIC_SetPriority(JOB_IRQn, JOB_IRQn_Priority, 0);
	HAL_NVIC_EnableIRQ(JOB_IRQn);

	return result;
}

/*
 * @brief  Perform the job associated to the current system state.
 * @param  None.
 */
void App_DoJob(void) {
	switch (winter.state) {
		case SYSTEM_STATE_INIT:
			do_InitJob();
			break;
		case SYSTEM_STATE_IDLE:
		case SYSTEM_STATE_IDLE_CONNECTED:
			do_IdleJob();
			break;
		case SYSTEM_STATE_LOG:
			do_LogJob();
			break;
		case SYSTEM_STATE_ERROR:
			do_ErrorJob();
			break;
		default:
			break;
	}

	handle_ScheduledOperations();
}

/*
 * @brief  Handler of the SysTick event.
 * @param  None.
 * @return None.
 */
void App_Handle_SysTick(void) {
	++myTick;

	// Schedule the main job
	if (myTick % App_GetPeriod() == 0) HAL_NVIC_SetPendingIRQ(JOB_IRQn);

	// Schedule the Bluetooth job
	if (myTick % 100 == 0) HAL_NVIC_SetPendingIRQ(BLE_JOB_IRQn);
}

/*
 * @brief  Handler of the double-tap event.
 * @param  None.
 * @return None.
 */
void App_Handle_DoubleTap(void) {
	LSM6DSL_Reset_DoubleTapInterrupt();
}

/*
 * @brief  Handler of the Bluetooth connection succeeded event.
 * @param  None.
 * @return None.
 */
void App_Handle_BTConnected(void) {
	if (App_GetSystemState() == SYSTEM_STATE_IDLE)
		App_SetSystemState(SYSTEM_STATE_IDLE_CONNECTED);
}

/*
 * @brief  Handler of the Bluetooth disconnection succeeded event.
 * @param  None.
 * @return None.
 */
void App_Handle_BTDisconnected(void) {
	switch (App_GetSystemState()) {
		case SYSTEM_STATE_IDLE_CONNECTED:
			// Get back to IDLE state
			App_SetSystemState(SYSTEM_STATE_IDLE);
			break;
		default:
			// Nothing to do
			break;
	}
}

/*
 * @brief  Deinitialize the unused peripherals.
 * @param  None.
 * @return The success of the operation.
 */
uint8_t App_DeinitPeripherals(void) {
	uint8_t result = 1;
	result &= LSM6DSL_PowerDown_Gyro(1);
	result &= HTS221_PowerDown(1);
	result &= LPS22HH_PowerDown(1);
	deinit_BluetoothLowEnergy();
	return result;
}

/*
 * @brief  Initialize the main structure of Winter.
 * @param  None.
 */
void init_Winter(void) {
// Default settings
	winter.logSensors = 0;
	winter.lastActivityTime = 0;
	winter.scheduledOperation = OP_NONE;
	winter.cardMounted = 0;
	winter.reachedLogBufferEnd = 0;
	winter.logFrequency = 0;
}

/*
 * @brief  Initialize LSM6DSL device with the default settings.
 * @param  None.
 * @return The success of the operation.
 */
uint8_t init_LSM6DSL(void) {
	if (LSM6DSL_Check_WhoAmI()) {
		uint8_t result = 1;
		LSM6DSL_Init_t config;

		// Default settings
		config.axl_odr = LSM6DSL_ODR_416Hz;
		config.axl_fs = LSM6DSL_FS_XL_2g;
		config.axl_mode = LSM6DSL_XL_HM_MODE_LOW_NORMAL;
		config.gyro_odr = LSM6DSL_ODR_416Hz;
		config.gyro_fs = LSM6DSL_FS_G_250dps;
		config.gyro_mode = LSM6DSL_G_HM_MODE_LOW_NORMAL;
		config.bdu = LSM6DSL_BDU_BLOCKING;

		// Double-tap settings
		config.int_enable = LSM6DSL_INTERRPUTS_ENABLED;
		config.int_enabledAxis =
				(0x07 << LSM6DSL_REG_TAP_CFG_AXIS_ENABLED_SHIFT);	// x, y, z
		config.int_lir = LSM6DSL_LIR_ENABLED;
		/*
		 * Threshold [5 bits]: 	x * axl_fs / 2^5
		 * Shock [2 bits]:		x != 0? x * 8 / axl_odr  : 4 / axl_odr
		 * Quiet [2 bits]:		x != 0? x * 4 / axl_odr  : 2 / axl_odr
		 * Duration [3 bits]:	x != 0? x * 32 / axl_odr : 16 / axl_odr
		 */
		config.int_tapThs = 0x0A;	// 625 mg
		config.int_tapShock = 0x03;	// 57.7 ms
		config.int_tapQuiet = 0x03;	// 28.8 ms
		config.int_tapDur = 0x05;	// 384.6 ms
		config.int_SDTapEnable = LSM6DSL_SDTAP_ENABLED;
		config.int1_dt = LSM6DSL_INT1_DTAP_ENABLED;

		result &= LSM6DSL_Config(&config);
		result &= LSM6DSL_Reset_DoubleTapInterrupt();

		return result;

	} else
		return 0;
}

/*
 * @brief  Initialize HTS221 device with the default settings.
 * @param  None.
 * @return The success of the operation.
 */
uint8_t init_HTS221(void) {
	if (HTS221_Check_WhoAmI())
		return HTS221_Config();
	else
		return 0;
}

/*
 * @brief  Initialize LPS22HH device with the default settings.
 * @param  None.
 * @return The success of the operation.
 */
uint8_t init_LPS22HH(void) {
	if (LPS22HH_Check_WhoAmI()) {
		LPS22HH_Init_t config;

		// Default settings
		config.odr = LPS22HH_ODR_10Hz;
		config.bdu = LPS22HH_BDU_BLOCKING;
		config.auto_inc_en = LPS22HH_IF_ADD_INC_ENABLED;
		config.low_noise_en = LPS22HH_LOW_NOISE_DISABLED;

		return LPS22HH_Config(&config);
	} else
		return 0;
}

/*
 * @brief  Initialize Bluetooth Low Energy module.
 * @param  None.
 * @return The success of the operation.
 */
uint8_t init_BluetoothLowEnergy(void) {
	/*Configure GPIO pin : BLE_CS_Pin */
	GPIO_InitTypeDef GPIO_InitStruct = { 0 };
	GPIO_InitStruct.Pin = BLE_CS_Pin;
	GPIO_InitStruct.Mode = GPIO_MODE_OUTPUT_PP;
	GPIO_InitStruct.Pull = GPIO_PULLUP;
	GPIO_InitStruct.Speed = GPIO_SPEED_FREQ_LOW;
	HAL_GPIO_Init(BLE_CS_GPIO_Port, &GPIO_InitStruct);

	// Initialize the module
	return BLE_Init();
}

/*
 * @brief  Deinitialize HTS221.
 * @param  None.
 * @return The success of the operation.
 */
uint8_t deinit_HTS221(void) {
	HTS221_PowerDown(1);
	return 1;
}

/*
 * @brief  Deinitialize LPS22HH.
 * @param  None.
 * @return The success of the operation.
 */
uint8_t deinit_LPS22HH(void) {
	LPS22HH_PowerDown(1);
	return 1;
}

/*
 * @brief  Deinitialize Bluetooth Low Energy module.
 * @param  None.
 * @return The success of the operation.
 */
void deinit_BluetoothLowEnergy(void) {
	/*Configure GPIO pin : BLE_CS_Pin */
	GPIO_InitTypeDef GPIO_InitStruct = { 0 };
	HAL_GPIO_WritePin(BLE_CS_GPIO_Port, BLE_CS_Pin, GPIO_PIN_RESET);
	GPIO_InitStruct.Pin = BLE_CS_Pin;
	GPIO_InitStruct.Mode = GPIO_MODE_ANALOG;
	GPIO_InitStruct.Pull = GPIO_NOPULL;
	HAL_GPIO_Init(BLE_CS_GPIO_Port, &GPIO_InitStruct);

	//TODO: RESET pin to analog

	// Deinitialize the BLE module
	BLE_DeInit();
}

/*
 * @brief  Initialization job:
 * 			- initialize the main structure;
 *			- initialize the peripherals and mount SD card;
 * 			- write the initialization status file.
 * @param  None.
 * @return The success of the operation.
 */
uint8_t do_InitJob(void) {
// Initialize the Winter main structure
	init_Winter();

	// Enable the power supply to the BT module and the SD card
	IO_Enable_VCC(GPIO_PIN_SET);

	// Initialize the LSM6DSL only if not dealing with a wake-up from STOP mode
	if (winter.oldState != SYSTEM_STATE_SLEEP) initStatus.LSM6DSL =
			init_LSM6DSL();

	// Initialize all other peripherals
	initStatus.HTS221 = init_HTS221();
	initStatus.LPS22HH = init_LPS22HH();
	initStatus.BLE = init_BluetoothLowEnergy();
	initStatus.MAX17048 = MAX17048_Read_SOC(&initStatus.batteryLevel);

	/*
	 * This part of code is not needed, as the BSP_SD_Init() function is
	 * already called when mounting the file system with f_mount() (see below)
	 *
	 // Configure the SD card
	 if (BSP_SD_Init() != MSD_OK) {
	 App_SetSystemState(SYSTEM_STATE_ERROR);
	 return 0;
	 }
	 */

	// Try to mount SD card
	/*winter.cardMounted = (f_mount(&FatFsDisk, SDPath, 1) == FR_OK);
	if (!winter.cardMounted) {
		App_SetSystemState(SYSTEM_STATE_ERROR);
		return 0;
	}

	// Create an init status log file
	if (!Log_Create_InitStatusFile(&initStatus)) {
		App_SetSystemState(SYSTEM_STATE_ERROR);
		return 0;
	}

	// Register DMA Callback for Mem2Mem DMA Transfer
	void (*funPtr)(DMA_HandleTypeDef*);
	funPtr = &MemToMemTxCplt;
	HAL_DMA_RegisterCallback(&hdma_memtomem_dma2_channel1,
			HAL_DMA_XFER_CPLT_CB_ID, funPtr);
	*/
	// Set the state as IDLE
	App_SetSystemState(SYSTEM_STATE_IDLE);

	return (initStatus.LSM6DSL & initStatus.HTS221 & initStatus.LPS22HH
			& initStatus.BLE);
}

/*
 * @brief  Idle job:
 * 			- check the idle-to-sleep timeout
 * 			- blink the blue LED.
 * @param  None.
 * @return None.
 */
void do_IdleJob(void) {
	// Check the idle-to-sleep timeout (only in case of SYSTEM_STATE_IDLE)
	if (myTick >= TIMEOUT_IDLE_TO_SLEEP
			&& App_GetSystemState() == SYSTEM_STATE_IDLE) {
		App_SetSystemState(SYSTEM_STATE_SLEEP);

	} else {
		// Blink the LED after a certain amount of function calls
		/*if ((myTick % LED_BLINK_PERIOD_IDLE) == 0) {
			IO_SetLED(LED_BLUE);
			HAL_Delay(10);
			IO_ResetLED(LED_BLUE);
		}*/
		//App_MyDebug(LED_GREEN);
		__NOP();
	}
}

/*
 * @brief  Log job:
 * 			- update the accelerometer and gyroscope readings;
 * 			- write the current readings to the log file;
 * 			- toggle the green LED.
 * @param  None.
 * @return None.
 */
void do_LogJob(void) {
	// Blink the LED after a certain amount of function calls
	if ((myTick % LED_BLINK_PERIOD_LOG) == 0) {
		IO_SetLED(LED_GREEN);
		HAL_Delay(10);
		IO_ResetLED(LED_GREEN);
	}

	updateData();
	Log_Write_Data();
}

/*
 * @brief  Error job:
 * 			- toggle the red LED.
 * @param  None.
 * @return None.
 */
void do_ErrorJob(void) {
	IO_ToggleLED(LED_RED);
}

/*
 * @brief  Handler of the scheduled operations.
 * @param  None.
 * @return None.
 */
void handle_ScheduledOperations(void) {
	if (winter.scheduledOperation != OP_NONE)
		switch (winter.scheduledOperation) {
			case OP_SHUTDOWN:
				if (HAL_GetTick()
						- winter.lastActivityTime>= RESTART_SHUTDOWN_DELAY) {
					//TODO shutdown
				}
				break;
			case OP_RESTART:
				if (HAL_GetTick()
						- winter.lastActivityTime>= RESTART_SHUTDOWN_DELAY) {
					HAL_NVIC_SystemReset();
				}
				break;
			default:
				break;
		}
}

/*
 * @brief  Update the readings from accelerometer and gyroscope.
 * @param  None.
 * @return The success of the operation.
 */
uint8_t updateData(void) {
	uint8_t result = 1;

	// Read from the inertial sensors only if required
	if ((winter.logSensors & SENS_AXL) != 0)
		result &= LSM6DSL_Read_Axl(latestData.axlDigits_sample,
				latestData.axl_sample);
	if ((winter.logSensors & SENS_GYRO) != 0)
		result &= LSM6DSL_Read_Gyro(latestData.gyroDigits_sample,
				latestData.gyro_sample);

	return result;
}

/*
 * @brief  Set the sensors whose data have to be logged.
 * @param  sensors The sensors to be logged. Each bit corresponds to a specific
 * 				   sensor, according to the masks defined in app.h.
 * @return None.
 */
void set_LogSensors(uint8_t sensors) {
	if (sensors != 0)
		winter.logSensors = sensors;
	else
		winter.logSensors = DEFAULT_LOG_SENSORS;
}

/*
 * @brief  Set the frequency at which data have to be logged.
 * @param  frequency The log frequency.
 * @return None.
 */
void set_LogFrequency(uint16_t frequency) {
	if (frequency > 0)
		winter.logFrequency = frequency;
	else
		winter.logFrequency = DEFAULT_LOG_PERIOD;
}
